alfreedom/BluePlant/Imágenes/13223656_626333700849686_1067302918_o.jpg

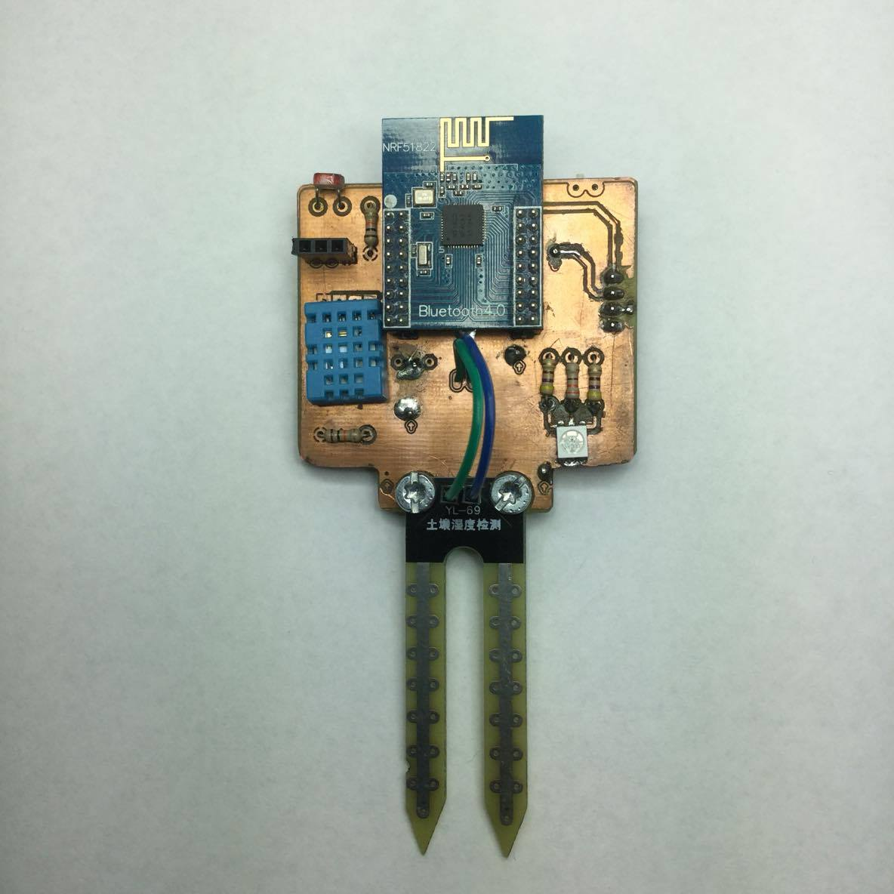
Imágenes/13223656_626333700849686_1067302918_o.jpg
