alfreedom/BluePlant/Imágenes/13235068_626333720849684_187252084_o.jpg

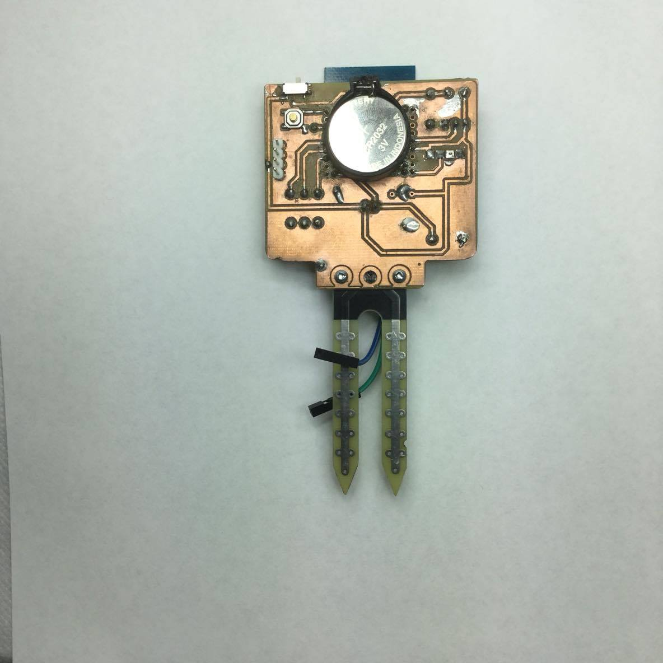
Imágenes/13235068_626333720849684_187252084_o.jpg
