alfreedom/BluePlant/README.md

# BluePlant
Dispositivo de sensado para plantas ornamentales y jardines
