alfreedom/BluePlant/Imágenes/13234934_626333480849708_149002704_o.jpg

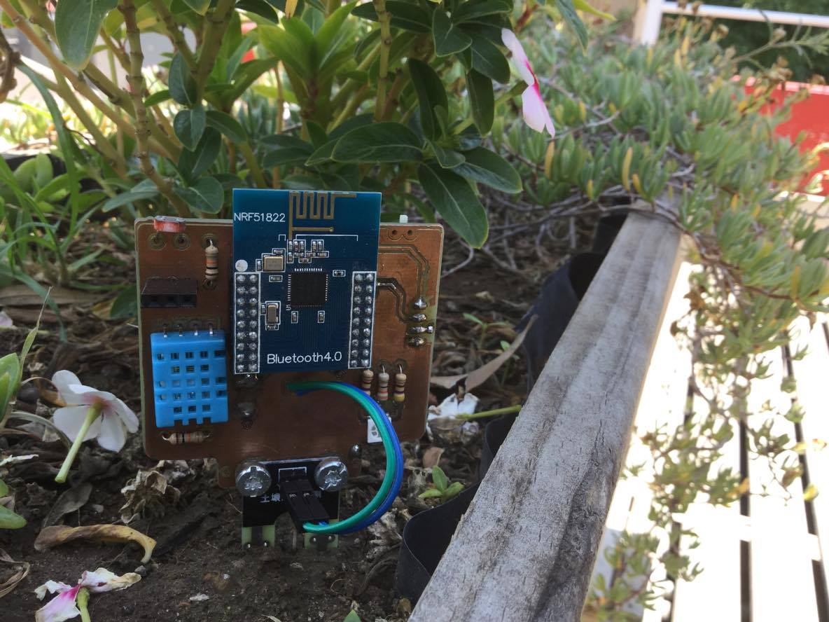
Imágenes/13234934_626333480849708_149002704_o.jpg
