alfreedom/BluePlant/Imágenes/13235067_626333490849707_612283233_o.jpg

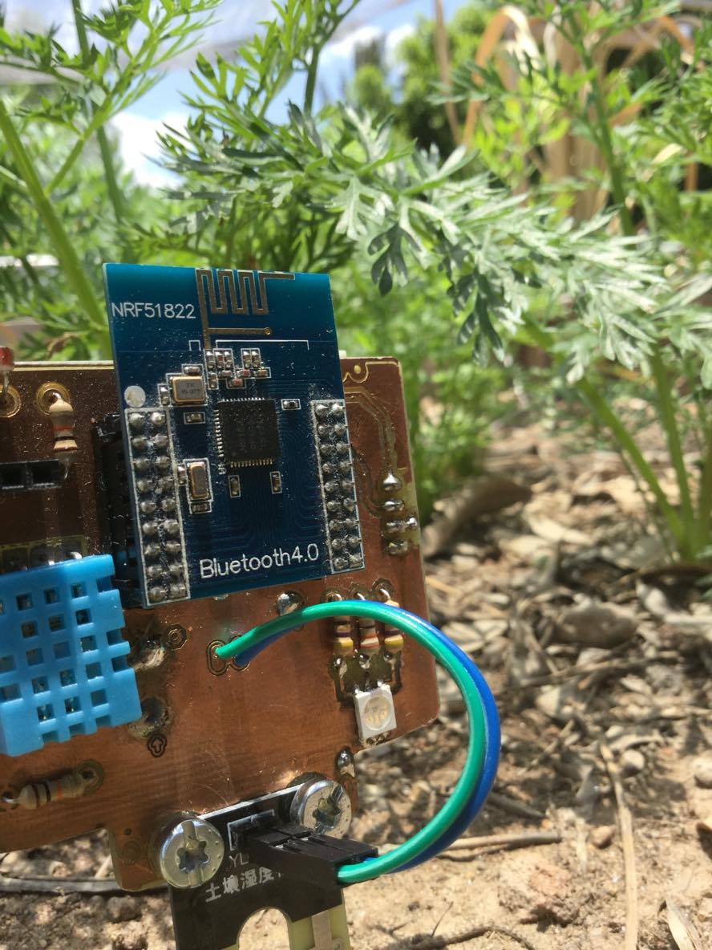
Imágenes/13235067_626333490849707_612283233_o.jpg
