alfreedom/BluePlant/Imágenes/13242325_626333564183033_653308717_o.jpg

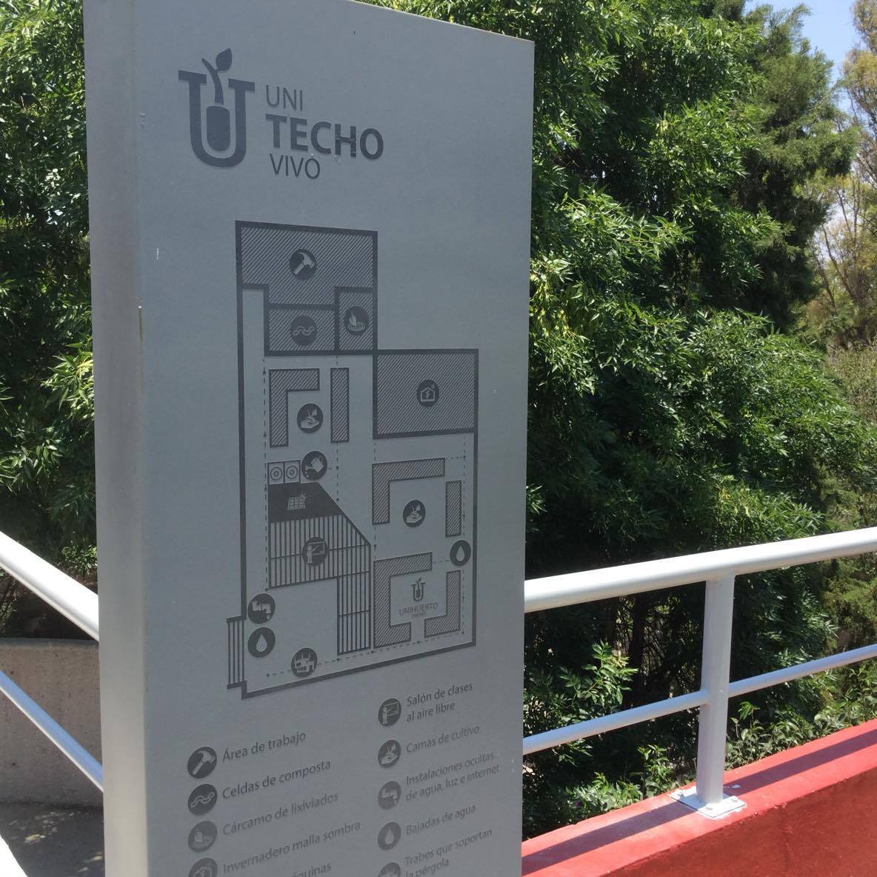
Imágenes/13242325_626333564183033_653308717_o.jpg
