alfreedom/BluePlant/Imágenes/13262315_626333530849703_928445110_o.jpg

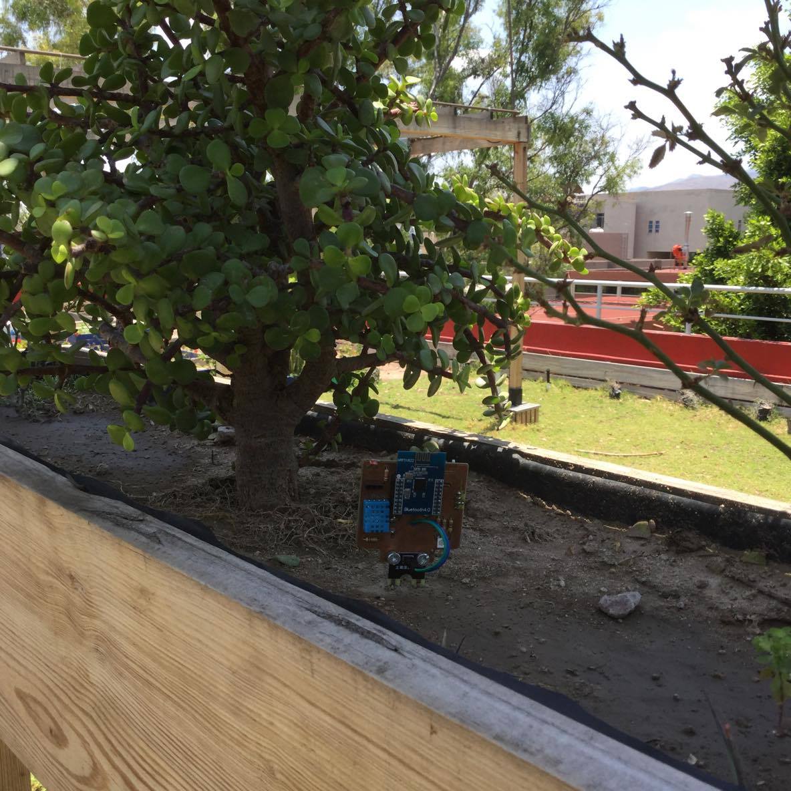
Imágenes/13262315_626333530849703_928445110_o.jpg
