alfreedom/BluePlant/Imágenes/13262644_626333534183036_110839598_o.jpg

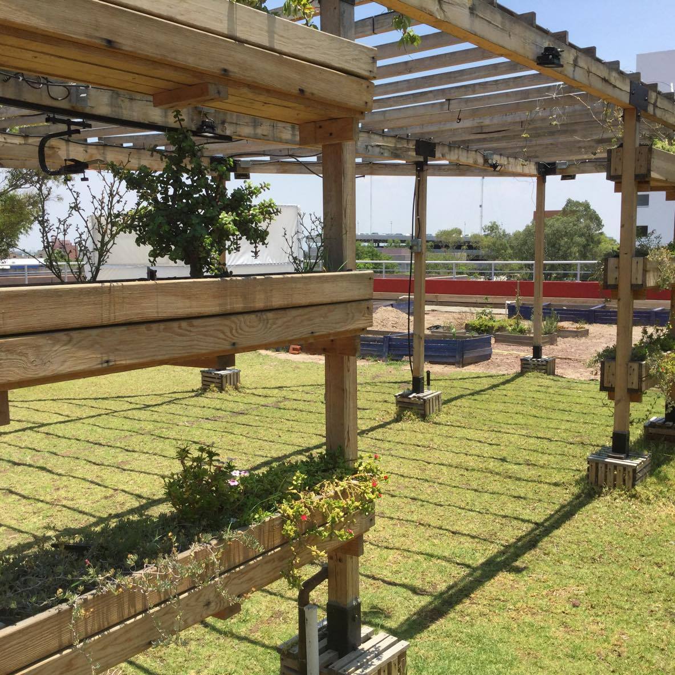
Imágenes/13262644_626333534183036_110839598_o.jpg
