alfreedom/BluePlant/blue_plant_1.0.pdf

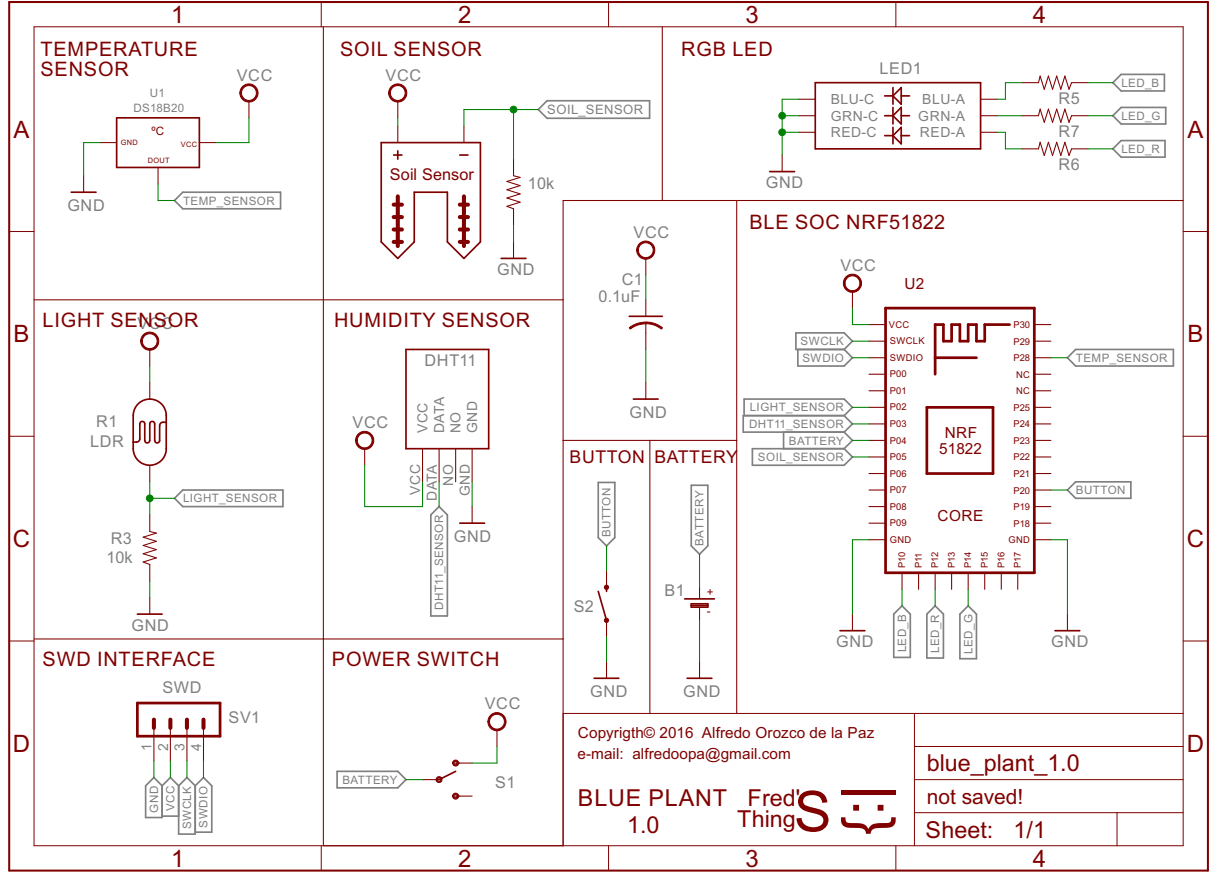
[picture p32: page 1]

TEMPERATURE SENSOR VCC U1 | SOIL SENSOR VCC | RGB LED LED1

Copyrigth© 2016 Alfredo Orozco de la Paz e-mail: alfredoopa@gmail.com BLUE PLANT | 1.0 ThingS Fred' {:

Sheet: 1/1
