alfreedom/BluePlant/eagle/blue_plant_1.0.brd

## EAGLE design eagle/blue_plant_1.0.brd (2017-12-05)

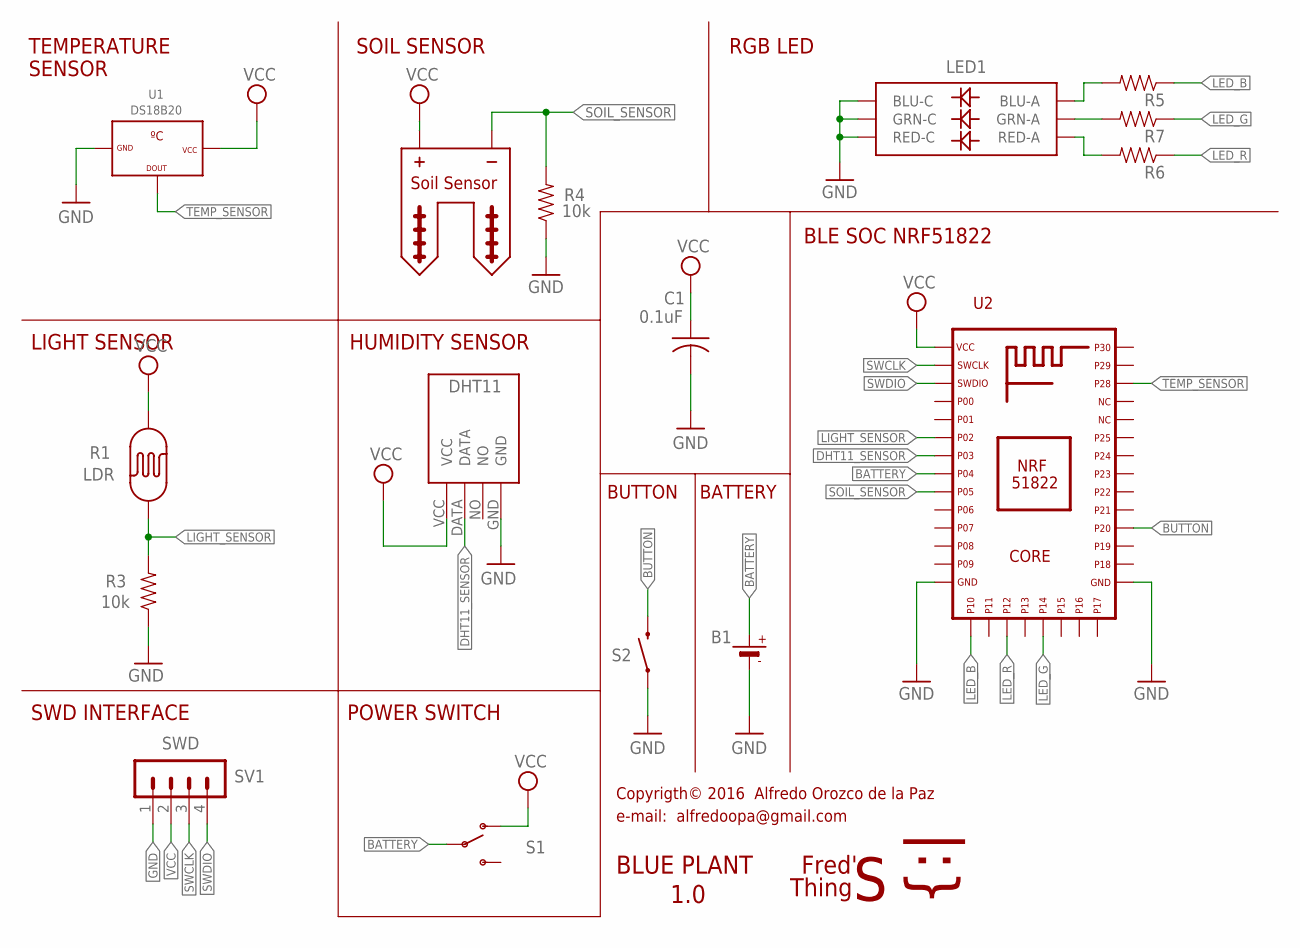
[picture p33: schematic blue_plant_1.0.sch]

Parts:
B1: BATTERYCR2032; CR2032
C1: 0.1uF; C025_050-025X075
LED1: RGB-5050; LED-TRICOLOR-5050
R1: LDR; PHOTOCELL-KIT
R2: SOIL-SENSOR; SOIL-SENSOR-1
R3, R4: 10k; AXIAL-0.3-KIT
R5, R6, R7: RESISTORKIT; AXIAL-0.3-KIT
S1: SWITCH-SPDT-SMD-A; SWITCH-SPST-SMD-A
S2: SWITCH-MOMENTARY-2SMD; TACTILE_SWITCH_SMD
SV1: SWD; MA04-1
U1: DS18B20; TO-92
U2: NRF51822-CORE-2; NRF51822-CORE2
U$1: DHT11

Connections:
BATTERY: B1.+, S1.2, U2.P18 (P04)
BUTTON: S2.3 (2), U2.P20
DHT11_SENSOR: U2.P17 (P03), U$1.DATA
GND: B1.-, C1.2, LED1.4 (BLU-C), LED1.5 (RED-C), LED1.6 (GRN-C), R3.P$1 (1), R4.P$1 (1), S2.1, SV1.1, U1.1 (GND), U2.P1 (GND1), U2.P12 (GND2), U$1.GND
LED_B: R5.P$1 (1), U2.P32 (P10)
LED_G: R7.P$1 (1), U2.P28 (P14)
LED_R: R6.P$1 (1), U2.P30 (P12)
LIGHT_SENSOR: R1.1, R3.P$2 (2), U2.P16 (P02)
unnamed: LED1.1 (GRN-A), R7.P$2 (2)
unnamed: LED1.3 (BLU-A), R5.P$2 (2)
unnamed: LED1.2 (RED-A), R6.P$2 (2)
SOIL_SENSOR: R2.P$1 (PG), R4.P$2 (2), U2.P35 (P05)
SWCLK: SV1.3, U2.P24 (SWDCLK)
SWDIO: SV1.4, U2.P23 (SWDIO)
TEMP_SENSOR: U1.2 (DOUT), U2.P9 (P28)
VCC: C1.1, R1.2, R2.P$2 (PS), S1.1 (O), SV1.2, U1.3 (VCC), U2.P11 (VCC), U$1.VCC

Notes on the sheet:
Copyrigth© 2016 Alfredo Orozco de la Paz
e-mail: alfredoopa@gmail.com
Fred'
{:|
BLUE PLANT
Thing
1.0
TEMPERATURE
SENSOR
SOIL SENSOR
RGB LED
BLE SOC NRF51822
POWER SWITCH
SWD INTERFACE
HUMIDITY SENSOR
LIGHT SENSOR
BUTTON
BATTERY

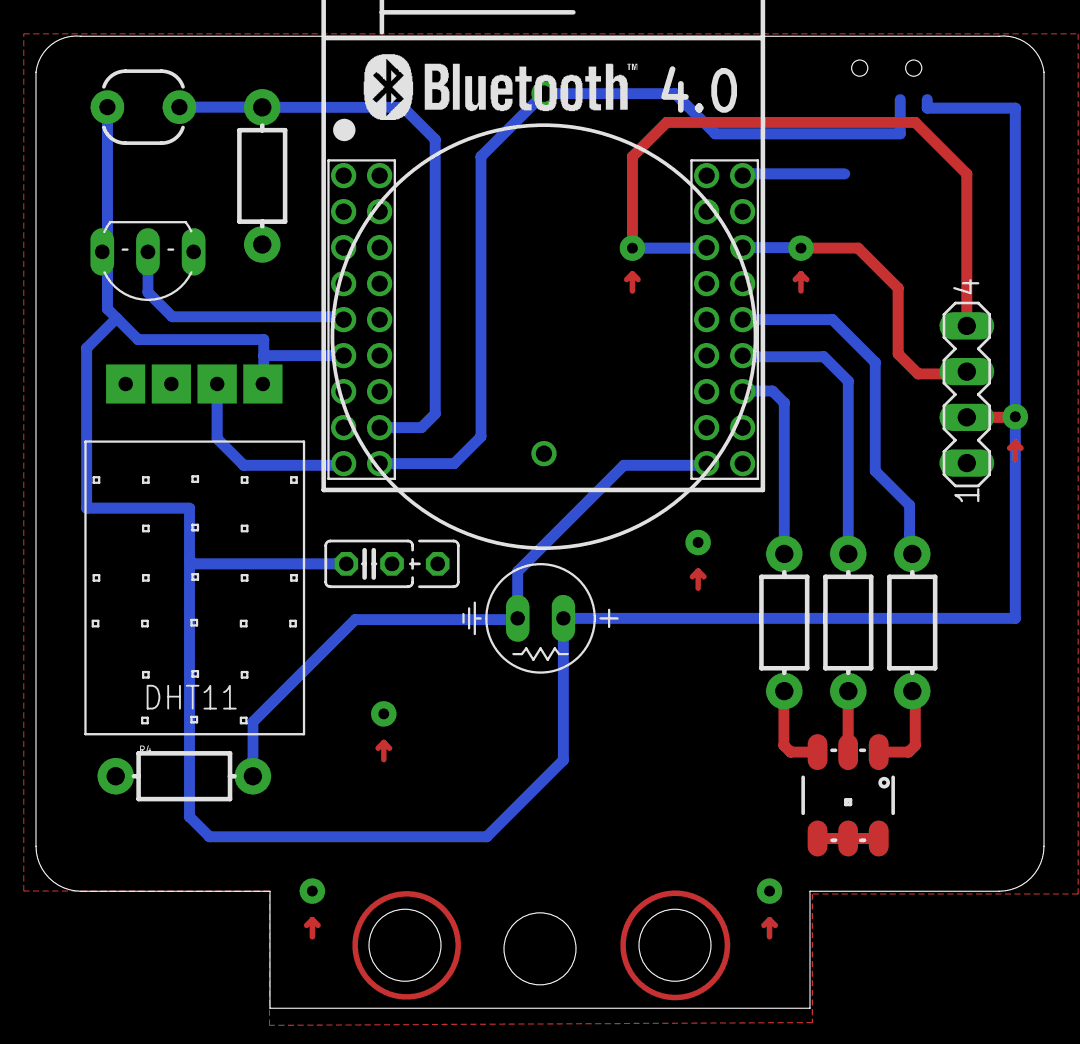
[picture p34: board blue_plant_1.0.brd from above]

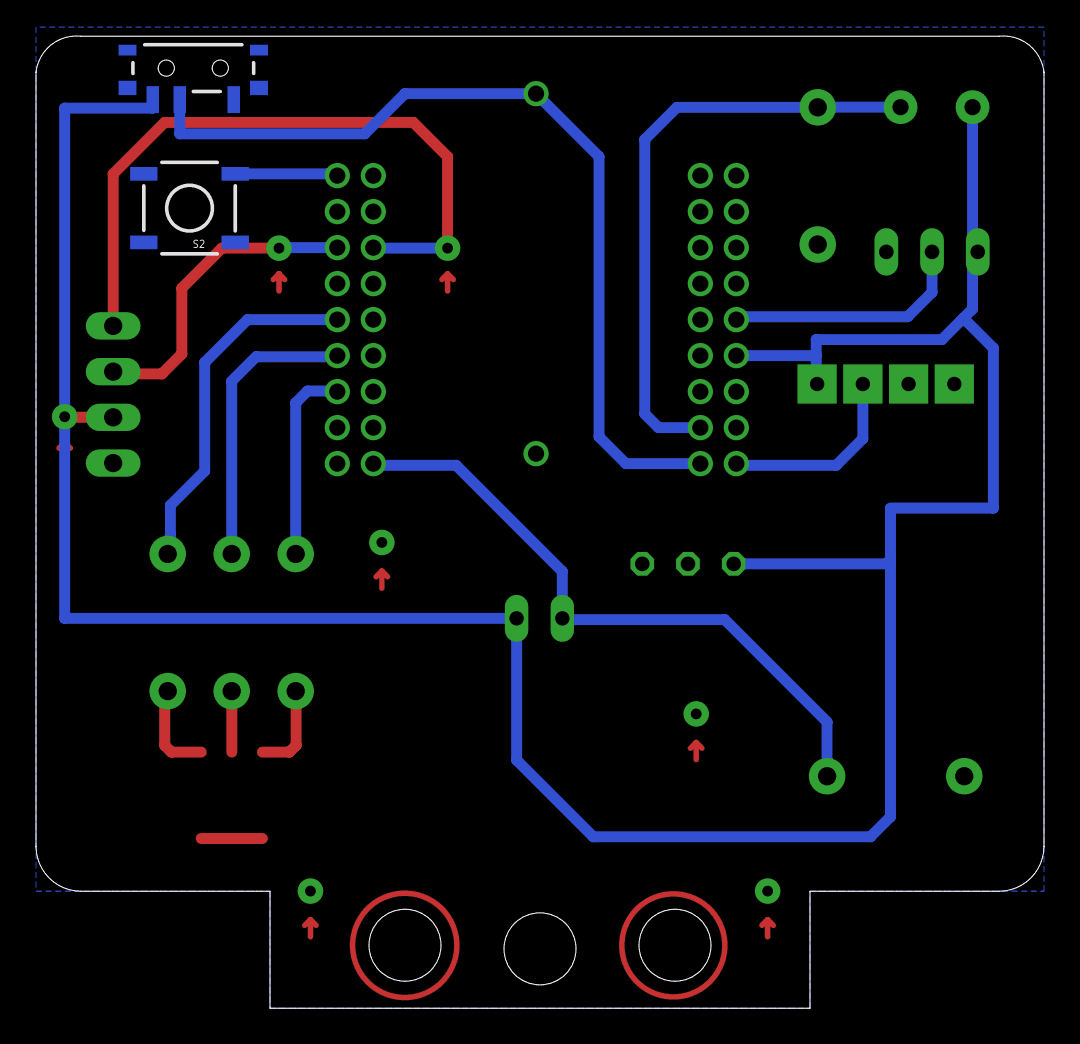
[picture p35: board blue_plant_1.0.brd from below]

Board: 2 copper layers, 56.0 x 54.0 mm, 16 parts (2 on the bottom side), 16 nets.
